wayneblaylock/landing-assist/README.md

# landing-assist

Pilot-facing landing-assist advisory for experimental-aircraft flight test.

- `hardware/` — schematic, bill of materials
- `display/` — pilot horizon GUI (artificial horizon, pitch cues, height tape)
- `firmware/` — ESP-IDF project for firmware
