wayneblaylock/landing-assist/case/README.md

Case design done in FreeCAD v1.1.4

Originaly started in Fusion360 but the cloud ecosystem is a nightmare, and was NOT lightweight.

'./sources/' - Files downloaded from the internet, or generated from other cad programs like KiCad.
'./assembly.FCstd' - The full assembly.
'./case.FCstd' - The 3D printed case.
