wayneblaylock/landing-assist/display/README.md

# Display

Static pilot horizon (ADI) page for the landing-assist system.

This is a single self-contained HTML file (`index.html`). It is the page the ESP32 serves over its SoftAP so the cockpit phone can open it.

To preview locally, open `index.html` in a browser. The Dev panel lets you move the cues until the ESP32 is feeding live data.
