wayneblaylock/landing-assist/hardware/KiCad/README.md

ECE Capstone KiCad schematic and PCB design files
