wayneblaylock/landing-assist/hardware/BOM/ECE Captstone BOM.xlsx

Sheet: BOM Final
Category | Manufacturer | Part Number | Description | QTY | Unit Price | Price Each | Notes | Source
SMD | Espressif Systems | ESP32-S3-WROOM-1U-N16R8 | Bluetooth, WiFi 802.11b/g/n, Bluetooth v5.0 Transceiver Module 2.4GHz Antenna Not Included, U.FL Surface Mount | 1 | $6.76 | $6.76 |  | https://www.digikey.com/en/products/detail/espressif-systems/ESP32-S3-WROOM-1U-N8R8/16162638
SMD | Bosch Sensortec | BMI088 | ACCELEROMETER 16LGA | 0 | $5.92 | $0.00 | OUT OF STOCK, | https://www.digikey.com/en/products/detail/bosch-sensortec/BMI088/8634936
SMD | Texas Instruments | TPS22919DCKR | Load Sw | 10 | $0.17 | $1.70 | Cut tape | https://www.digikey.com/en/products/detail/texas-instruments/TPS22919DCKR/10434801
Connector | Amphenol ICC (FCI) | 10176546-00011LF | USB-C (USB TYPE-C) Receptacle Connector 24 (16+8 Dummy) Position Through Hole, Right Angle | 3 | $1.13 | $3.39 |  | https://www.digikey.com/en/products/detail/amphenol-cs-fci/10176546-00011LF/26473252
Connector | JST | SM08B-SURS-TF | JST SUR 8 position right angle connector SMT | 3 | $1.04 | $3.12 | For Lidar May also use vertical version if desired(BM08B-SURS-TF) | https://www.digikey.com/en/products/detail/jst-sales-america-inc/SM08B-SURS-TF/1634781
SMD | Microchip Technology | MCP73831T-2ACI/OT | Lion CCCV Charger | 3 | $0.76 | $2.28 |  | https://www.digikey.com/en/products/detail/microchip-technology/MCP73831T-2ACI-OT/964301
SMD | Texas Instruments | LM27313XMF/NOPB | IC REG BOOST ADJ 800MA SOT23-5 | 3 | $2.52 | $7.56 |  | https://www.digikey.com/en/products/detail/texas-instruments/LM27313XMF-NOPB/1590046
SMD | Texas Instruments | TPS62162DSGR | IC REG BUCK 3.3V 1A 8WSON | 3 | $1.99 | $5.97 |  | https://www.digikey.com/en/products/detail/texas-instruments/TPS62162DSGR/2833447
Connector | JST | S2B-PH-K-S | JST-PH 2 pos | 3 | $0.12 | $0.36 | for battery connection | https://www.digikey.com/en/products/detail/jst-sales-america-inc/S2B-PH-K-S/926626
Passives | onsemi | MBR0520LT3G | DIODE SCHOTTKY 20V 500MA SOD123 | 3 | $0.37 | $1.11 |  | https://www.digikey.com/en/products/detail/onsemi/MBR0520LT3G/1477142
Passives | Murata Electronics | GRM033R61A104ME15D | CAP CER 0.1UF 10V X5R 0201 | 50 | $0.01 | $0.47 |  | https://www.digikey.com/en/products/detail/murata-electronics/GRM033R61A104ME15D/2175191
Passives | Murata Electronics | GRT188R61C106KE13D | CAP CER 10UF 16V X5R 0603 | 10 | $0.17 | $1.75 |  | https://www.digikey.com/en/products/detail/murata-electronics/GRT188R61C106KE13D/5416739
Passives | Murata Electronics | GCM188R71E105KA64D | CAP CER 1UF 25V X7R 0603 | 10 | $0.11 | $1.09 |  | https://www.digikey.com/en/products/detail/murata-electronics/GCM188R71E105KA64D/4903956
Passives | Murata Electronics | GRM188R61E475KE11D | 4.7 µF ±10% 25V Ceramic Capacitor X5R 0603 (1608 Metric) | 10 | $0.14 | $1.41 |  | https://www.digikey.com/en/products/detail/murata-electronics/GRM188R61E475KE11D/3900465
Passives |  |  | LED, THT, 5mm | 0 |  | $0.00 | do not purchase
Passives | TDK | VLS6045EX-100M | FIXED IND 10UH 3.4A 47 MOHM SMD | 3 | $0.35 | $1.05 | cut tape | https://www.digikey.com/en/products/detail/tdk/VLS6045EX-100M/5057822
Passives | TDK | VLS252012ET-2R2M | FIXED IND 2.2UH 1.3A 154 MOHM | 3 | $0.28 | $0.84 | cut tape | https://www.digikey.com/en/products/detail/tdk/VLS252012ET-2R2M/2465978
Passives | YAGEO | RC0402FR-0710KL | 10 kOhms ±1% 0.063W, 1/16W Chip Resistor 0402 (1005 Metric) Moisture Resistant Thick Film | 25 | $0.02 | $0.38 |  | https://www.digikey.com/en/products/detail/yageo/RC0402FR-0710KL/726523
Passives | YAGEO | RC0402FR-071KL | 1 kOhms ±1% 0.063W, 1/16W Chip Resistor 0402 (1005 Metric) Moisture Resistant Thick Film | 25 | $0.02 | $0.38 |  | https://www.digikey.com/en/products/detail/yageo/RC0402FR-071KL/726513
Passives | YAGEO | RC0402JR-074K7L | RES 4.7K OHM 5% 1/16W 0402 | 25 | $0.01 | $0.36 |  | https://www.digikey.com/en/products/detail/yageo/RC0402JR-074K7L/726477
Passives | YAGEO | RC0402FR-075K1L | 5.1 kOhms ±1% 0.063W, 1/16W Chip Resistor 0402 (1005 Metric) Moisture Resistant Thick Film | 25 | $0.02 | $0.38 |  | https://www.digikey.com/en/products/detail/yageo/RC0402FR-075K1L/726624
Passives | YAGEO | AC0402FR-07309KL | 309 kOhms ±1% 0.063W, 1/16W Chip Resistor 0402 (1005 Metric) Automotive AEC-Q200, Moisture Resistant Thick Film | 10 | $0.02 | $0.24 |  | https://www.digikey.com/en/products/detail/yageo/AC0402FR-07309KL/5895272
Passives | YAGEO | RC0402FR-07100KL | RES 100K OHM 1% 1/16W 0402 | 10 | $0.02 | $0.21 |  | https://www.digikey.com/en/products/detail/yageo/RC0402FR-07100KL/726526
SMD | C&K | PTS645SH43SMTR92 LFS | SWITCH TACTILE SPST-NO 0.05A 12V | 5 | $0.39 | $1.95 |  | https://www.digikey.com/en/products/detail/c-k/PTS645SH43SMTR92-LFS/1145472
Breakout | Espressif Systems | ESP32-S3-DEVKITC-1U-N8R8 | ESP32-S3 development board using ESP32-S3-WROOM-1U-N8R8; Wi-Fi + BLE | 2 | $15.31 | $30.62 | the module on it is ESP32-S3-WROOM-1U-N8R8. | https://www.mouser.com/en/ProductDetail/Espressif-Systems/ESP32-S3-DevKitC-1U-N8R8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
Final | TE Connectivity Measurement Specialties | 4525DO-DS5AI001DP | 1 psi differential pressure sensor, 14-bit, dual 0.14 in barbed ports | 1 | $72.41 | $72.41 | This will be the final soldered part, but we can test using small clamps/leads to the through-hole pins .5 V supply; differential pressure; intended for pitot/static airspeed measurement. | https://www.digikey.com/en/products/detail/te-connectivity-measurement-specialties/4525DO-DS5AI001DP/3569051
Breakout | Bosch Sensortec | 828-SHUTTLEBOARD3.0BMI088-ND | Breakout: 6-axis accelerometer + gyroscope IMU, I2C/SPI, 16-LGA | 2 | $16.20 | $32.40 | Breakout version of the part to be used (BMI088) | https://www.digikey.com/en/products/detail/bosch-sensortec/SHUTTLE-BOARD-3-0-BMI088/14617528
Final | LightWare LiDAR Inc. | SF20/C | 100 m-class optical distance sensor, I2C / serial, 4.5-5.5 V | 1 | $319.00 | $319.00 | Please order at mouser, out of stock at digikey. | https://www.digikey.com/en/products/detail/lightware-lidar-inc/SF20-C/15848650
Harness (Final) | JST | A08SUR08SUR32W102B | JST SUR 8 pos cable 4” | 2 | $2.13 | $4.26 | I think 1:N is correct based on the provided datasheet | https://www.digikey.com/en/products/detail/jst-sales-america-inc/A08SUR08SUR32W102B/9947457
Breakout | LightWare LiDAR Inc. | ACC_BOB_08SUR-32S | lightware breakout board | 0 |  | $0.00 | do not purchase
Antenna (Final) | Pulse Electronics | W1049B050 | RF ANTENNA Bluetooth, Wi-Fi, WLAN, Zigbee™ Whip, Tilt U.FL (UMCC), I-PEX MHF1 Connector Mount | 1 | $4.49 | $4.49 | U.FL direct | https://www.digikey.com/en/products/detail/pulse-electronics/W1049B050/2267887
Coax Adapter | Adafruit | 852 | RP-SMA to uFL/u.FL/IPX/IPEX RF Adapter Cable | 0 |  | $0.00 | do not purchase | https://www.digikey.com/en/products/detail/adafruit-industries-llc/852/6827042
Pneumatic Tubing |  |  | Tubing 5ft | 0 |  | $0.00 | do not purchase | https://www.mcmaster.com/2121T15-2121T151/
Battery (Final) | Adafruit | 1781 | 18650 3.7 V Lithium-Ion Battery Rechargeable (Secondary) 2.2Ah | 2 | $9.95 | $19.90 |  | https://www.digikey.com/en/products/detail/adafruit-industries-llc/1781/5054543
Testing | DFRobot | KIT0198-US | GNSS-RTK High Precision Positioning Kit with LoRa (US 915 MHz, GPS / GLONASS / Galileo / BDS / QZSS) | 1 | $169.00 | $169.00 | for calibrating sensors | https://www.digikey.com/en/products/detail/dfrobot/KIT0198-US/28531129
PCB |  | PCB Estimate | PCB with Stencil estimate from JLCPCB and PCBWay | 1 | $90.00 | $90.00 | Estimate only; not for immediate purchase, unit cost is actually qty 5 pcbs totalling $90
Solder Paste | Chip Quik Inc. | NC191LT10 |  | 1 | $17.99 | $17.99 |  | https://www.digikey.com/en/products/detail/chip-quik-inc/SMD291AXT4/8543521
 |  |  |  | Total |  | $802.83

Sheet: BOM PCB
Category | Manufacturer | Part Number | Description | QTY | Price | Notes | Source | Source2
SMD | Espressif Systems | ESP32-S3-WROOM-1U-N16R8 | Bluetooth, WiFi 802.11b/g/n, Bluetooth v5.0 Transceiver Module 2.4GHz Antenna Not Included, U.FL Surface Mount | 1 | 6.76 |  | https://www.digikey.com/en/products/detail/espressif-systems/ESP32-S3-WROOM-1U-N8R8/16162638
SMD | Bosch Sensortec | BMI088 | ACCELEROMETER 16LGA | 0 | 5.92 | OUT OF STOCK, | https://www.digikey.com/en/products/detail/bosch-sensortec/BMI088/8634936 | https://www.mouser.com/en/ProductDetail/Bosch-Sensortec/BMI088?qs=f9yNj16SXrIMFspTV6RB6Q%3D%3D
SMD | Texas Instruments | TPS22919DCKR | Load Sw | 10 | 1.7 | Cut tape | https://www.digikey.com/en/products/detail/texas-instruments/TPS22919DCKR/10434801
Connector | Amphenol ICC (FCI) | 10176546-00011LF | USB-C (USB TYPE-C) Receptacle Connector 24 (16+8 Dummy) Position Through Hole, Right Angle | 3 | 3.39 |  | https://www.digikey.com/en/products/detail/amphenol-cs-fci/10176546-00011LF/26473252
Connector | JST | SM08B-SURS-TF | JST SUR 8 position right angle connector SMT | 3 | 3.12 | For Lidar May also use vertical version if desired(BM08B-SURS-TF) | https://www.digikey.com/en/products/detail/jst-sales-america-inc/SM08B-SURS-TF/1634781
SMD | Microchip Technology | MCP73831T-2ACI/OT | Lion CCCV Charger | 3 | 2.28 |  | https://www.digikey.com/en/products/detail/microchip-technology/MCP73831T-2ACI-OT/964301
SMD | Texas Instruments | LM27313XMF/NOPB | IC REG BOOST ADJ 800MA SOT23-5 | 3 | 7.56 |  | https://www.digikey.com/en/products/detail/texas-instruments/LM27313XMF-NOPB/1590046
SMD | Texas Instruments | TPS62162DSGR | IC REG BUCK 3.3V 1A 8WSON | 3 | 5.97 |  | https://www.digikey.com/en/products/detail/texas-instruments/TPS62162DSGR/2833447
Connector | JST | S2B-PH-K-S | JST-PH 2 pos | 3 | 0.36 | for battery connection | https://www.digikey.com/en/products/detail/jst-sales-america-inc/S2B-PH-K-S/926626
Passives | onsemi | MBR0520LT3G | DIODE SCHOTTKY 20V 500MA SOD123 | 3 | 1.11 |  | https://www.digikey.com/en/products/detail/onsemi/MBR0520LT3G/1477142
Passives | Murata Electronics | GRM033R61A104ME15D | CAP CER 0.1UF 10V X5R 0201 | 50 | 0.44 |  | https://www.digikey.com/en/products/detail/murata-electronics/GRM033R61A104ME15D/2175191
Passives | Murata Electronics | GRT188R61C106KE13D | CAP CER 10UF 16V X5R 0603 | 10 | 1.75 |  | https://www.digikey.com/en/products/detail/murata-electronics/GRT188R61C106KE13D/5416739
Passives | Murata Electronics | GCM188R71E105KA64D | CAP CER 1UF 25V X7R 0603 | 10 | 1.09 |  | https://www.digikey.com/en/products/detail/murata-electronics/GCM188R71E105KA64D/4903956
Passives | Murata Electronics | GRM188R61E475KE11D | 4.7 µF ±10% 25V Ceramic Capacitor X5R 0603 (1608 Metric) | 10 | 1.41 |  | https://www.digikey.com/en/products/detail/murata-electronics/GRM188R61E475KE11D/3900465
Passives |  |  | LED, THT, 5mm | 0 |  | do not purchase
Passives | TDK | VLS6045EX-100M | FIXED IND 10UH 3.4A 47 MOHM SMD | 3 | 1.05 | cut tape | https://www.digikey.com/en/products/detail/tdk/VLS6045EX-100M/5057822
Passives | TDK | VLS252012ET-2R2M | FIXED IND 2.2UH 1.3A 154 MOHM | 3 | 0.84 | cut tape | https://www.digikey.com/en/products/detail/tdk/VLS252012ET-2R2M/2465978
Passives | YAGEO | RC0402FR-0710KL | 10 kOhms ±1% 0.063W, 1/16W Chip Resistor 0402 (1005 Metric) Moisture Resistant Thick Film | 25 | 0.38 |  | https://www.digikey.com/en/products/detail/yageo/RC0402FR-0710KL/726523
Passives | YAGEO | RC0402FR-071KL | 1 kOhms ±1% 0.063W, 1/16W Chip Resistor 0402 (1005 Metric) Moisture Resistant Thick Film | 25 | 0.38 |  | https://www.digikey.com/en/products/detail/yageo/RC0402FR-071KL/726513
Passives | YAGEO | RC0402JR-074K7L | RES 4.7K OHM 5% 1/16W 0402 | 25 | 0.36 |  | https://www.digikey.com/en/products/detail/yageo/RC0402JR-074K7L/726477
Passives | YAGEO | RC0402FR-075K1L | 5.1 kOhms ±1% 0.063W, 1/16W Chip Resistor 0402 (1005 Metric) Moisture Resistant Thick Film | 25 | 0.38 |  | https://www.digikey.com/en/products/detail/yageo/RC0402FR-075K1L/726624
Passives | YAGEO | AC0402FR-07309KL | 309 kOhms ±1% 0.063W, 1/16W Chip Resistor 0402 (1005 Metric) Automotive AEC-Q200, Moisture Resistant Thick Film | 10 | 0.24 |  | https://www.digikey.com/en/products/detail/yageo/AC0402FR-07309KL/5895272
Passives | YAGEO | RC0402FR-07100KL | RES 100K OHM 1% 1/16W 0402 | 10 | 0.21 |  | https://www.digikey.com/en/products/detail/yageo/RC0402FR-07100KL/726526
SMD | C&K | PTS645SH43SMTR92 LFS | SWITCH TACTILE SPST-NO 0.05A 12V | 5 | 1.95 |  | https://www.digikey.com/en/products/detail/c-k/PTS645SH43SMTR92-LFS/1145472

Sheet: BOM Breadboard
Category | Manufacturer | Part Number | Description | QTY | Price | Notes | Source | Source2
Breakout | Espressif Systems | ESP32-S3-DEVKITC-1U-N8R8 | ESP32-S3 development board using ESP32-S3-WROOM-1U-N8R8; Wi-Fi + BLE | 2 | $15 | Linked DigiKey board is the DevKitC; the module on it is ESP32-S3-WROOM-1U-N8R8. | https://www.digikey.com/en/products/detail/espressif-systems/ESP32-S3-DEVKITC-1U-N8R8/16162636 | https://www.mouser.com/en/ProductDetail/Espressif-Systems/ESP32-S3-DevKitC-1U-N8R8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
Final | TE Connectivity Measurement Specialties | 4525DO-DS5AI001DP | 1 psi differential pressure sensor, 14-bit, dual 0.14 in barbed ports | 1 | $72.41 | This will be the final soldered part, but we can test using small clamps/leads to the through-hole pins .5 V supply; differential pressure; intended for pitot/static airspeed measurement. | https://www.digikey.com/en/products/detail/te-connectivity-measurement-specialties/4525DO-DS5AI001DP/3569051 | https://www.mouser.com/en/ProductDetail/TE-Connectivity-Measurement-Specialties/4525DO-DS5AI001DP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
Breakout | Bosch Sensortec | 828-SHUTTLEBOARD3.0BMI088-ND | Breakout: 6-axis accelerometer + gyroscope IMU, I2C/SPI, 16-LGA | 2 | $32.40 | Breakout version of the part to be used (BMI088) | https://www.digikey.com/en/products/detail/bosch-sensortec/SHUTTLE-BOARD-3-0-BMI088/14617528
Final | LightWare LiDAR Inc. | SF20/C | 100 m-class optical distance sensor, I2C / serial, 4.5-5.5 V | 1 | $319.00 | Consider SF20/C instead, in stock at mouser | https://www.mouser.com/en/ProductDetail/LightWare-LiDAR/SF20-C?qs=iLbezkQI%252Bsj8XPNk6jtsvg%3D%3D
Harness (Final) | JST | A08SUR08SUR32W102B | JST SUR 8 pos cable 4” | 2 | 4.26 | I think 1:N is correct based on the provided datasheet | https://www.digikey.com/en/products/detail/jst-sales-america-inc/A08SUR08SUR32W102B/9947457
Breakout | LightWare LiDAR Inc. | ACC_BOB_08SUR-32S | lightware breakout board | 0 |  | do not purchase
Antenna (Final) | Pulse Electronics | W1049B050 | RF ANTENNA Bluetooth, Wi-Fi, WLAN, Zigbee™ Whip, Tilt U.FL (UMCC), I-PEX MHF1 Connector Mount | 1 | 4.49 | U.FL direct | https://www.digikey.com/en/products/detail/pulse-electronics/W1049B050/2267887
Coax Adapter | Adafruit | 852 | RP-SMA to uFL/u.FL/IPX/IPEX RF Adapter Cable | 0 |  | do not purchase | https://www.digikey.com/en/products/detail/adafruit-industries-llc/852/6827042
Pneumatic Tubing |  |  |  | 0 |  | do not purchase
Battery (Final) | Adafruit | 1781 | 18650 3.7 V Lithium-Ion Battery Rechargeable (Secondary) 2.2Ah | 2 | 19.9 |  | https://www.digikey.com/en/products/detail/adafruit-industries-llc/1781/5054543

Sheet: Sheet1
Category | Manufacturer | Part Number | Description | QTY | Price | Notes | Source
MCU | Espressif Systems | ESP32-S3-DEVKITC-1U-N8R8 | ESP32-S3 development board using ESP32-S3-WROOM-1U-N8R8; Wi-Fi + BLE | 1 | $15 | Linked DigiKey board is the DevKitC; the module on it is ESP32-S3-WROOM-1U-N8R8. | https://www.digikey.com/en/products/detail/espressif-systems/ESP32-S3-DEVKITC-1U-N8R8/16162636
Airspeed | TE Connectivity Measurement Specialties | 4525DO-DS5AI001DP | 1 psi differential pressure sensor, 14-bit, dual 0.14 in barbed ports | 1 | $72.41 | 5 V supply; differential pressure; intended for pitot/static airspeed measurement. | https://www.digikey.com/en/products/detail/te-connectivity-measurement-specialties/4525DO-DS5AI001DP/3569051
IMU | Bosch Sensortec | BMI088 | 6-axis accelerometer + gyroscope IMU, I2C/SPI, 16-LGA | 1 | $5.92 | Surface-mount part for final PCB; -40 C to +85 C operating range. | https://www.digikey.com/en/products/detail/bosch-sensortec/BMI088/8634936
LiDAR | LightWare LiDAR Inc. | LW20/C | 100 m-class optical distance sensor, I2C / serial, 4.5-5.5 V | 1 | $299.30 | 20 cm to 100 m sensing range; about 100 mA supply per DigiKey. | https://www.digikey.com/en/products/detail/lightware-lidar-inc/LW20-C/15848653
Battery Option A | Adafruit | Product ID 1781 | 3.7 V 2200 mAh protected lithium-ion cylindrical battery with JST-PH | 1 | $9.95 | Lower-cost/lower-capacity battery option. | https://www.adafruit.com/product/1781
Battery Option B | Adafruit | Product ID 354 | 3.7 V 4400 mAh protected lithium-ion battery pack with JST connector | 1 | $19.95 | Higher-capacity option; larger/heavier than 2200 mAh pack. | https://www.adafruit.com/product/354
Battery Charger Option A | Microchip Technology | MCP73831T-2ACI/OT | Single-cell Li-Ion/Li-Poly charger IC, programmable charge current | 1 | $0.76 | 4.2 V single-cell charger; up to 500 mA charge current for this part. | https://www.digikey.com/en/products/detail/microchip-technology/MCP73831T-2ACI-OT/964301
Battery Charger Option B | Texas Instruments | BQ21040DBVR | Single-cell Li-Ion/Li-Poly charger IC, programmable charging | 1 | $0.99 | 4.2 V single-cell charger; 6.45 V max supply. | https://www.digikey.com/en/products/detail/texas-instruments/BQ21040DBVR/6036340
5 V Boost Regulator | Texas Instruments | LM27313XMF/NOPB | Adjustable boost regulator, 5 V minimum output setting, 800 mA switch | 1 | $2.42 | 2.7-14 V input; use external inductor/diode/capacitors per datasheet. | https://www.digikey.com/en/products/detail/texas-instruments/LM27313XMF-NOPB/1590046
3.3 V Regulator Option A | Semtech Corporation | SC189ZSKTRT | 3.3 V fixed buck regulator, 1.5 A | 1 | $1.07 | 2.9-5.5 V input. Check dropout/operation near a discharged 1-cell Li-ion battery. | https://www.digikey.com/en/products/detail/semtech-corporation/SC189ZSKTRT/2182360
3.3 V Regulator Option B | Texas Instruments | TPS62162DSGR | 3.3 V fixed buck regulator, 1 A | 1 | $1.86 | 3-17 V input. Check operation as battery approaches 3.3 V. | https://www.digikey.com/en/products/detail/texas-instruments/TPS62162DSGR/2833447
Total (including alternative) | $429.63
Core total (ESP32 + airspeed + IMU + LiDAR + LiDAR connector + 2200mAh battery + MCP73831 + LM27313) |  |  | $405.76
