wayneblaylock/landing-assist/case/assembly.FCStd

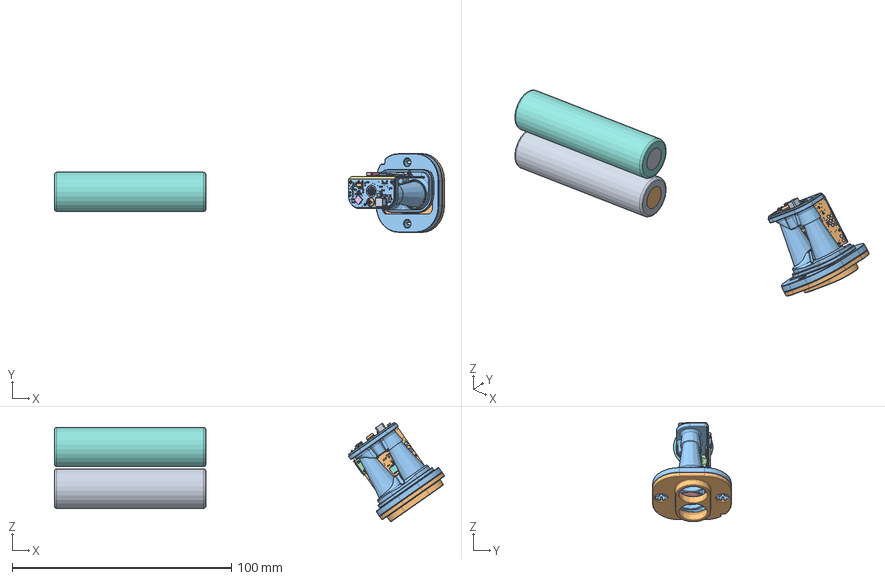
[picture p1: CAD file, 2026-10-19]
case/assembly.FCStd
177.8 x 36.0 x 45.3 mm
2200mAh Battery v1
2200mAh Battery v001
(Unsaved)
(Unsaved)001
(Unsaved)002
(Unsaved)003
(Unsaved)004
(Unsaved)005
(Unsaved)006
(Unsaved)007
(Unsaved)008
(Unsaved)009
(Unsaved)010
(Unsaved)011
(Unsaved)012
(Unsaved)013
(Unsaved)014
(Unsaved)015
(Unsaved)016
(Unsaved)017
(Unsaved)018
(Unsaved)019
(Unsaved)020
(Unsaved)021
(Unsaved)022
(Unsaved)023
(Unsaved)024
(Unsaved)025
(Unsaved)026
(Unsaved)027
(Unsaved)028
(Unsaved)029
(Unsaved)030
(Unsaved)031
(Unsaved)032
(Unsaved)033
(Unsaved)034
(Unsaved)035
(Unsaved)036
(Unsaved)037
(Unsaved)038
(Unsaved)039
(Unsaved)040
(Unsaved)041
(Unsaved)042
(Unsaved)043
(Unsaved)044
(Unsaved)045
(Unsaved)046
(Unsaved)047
(Unsaved)048
(Unsaved)049
(Unsaved)050
(Unsaved)051
(Unsaved)052
(Unsaved)053
(Unsaved)054
(Unsaved)055
(Unsaved)056
(Unsaved)057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
