wayneblaylock/landing-assist/case/sources/LightWare SF20 Mounting Bracket.step

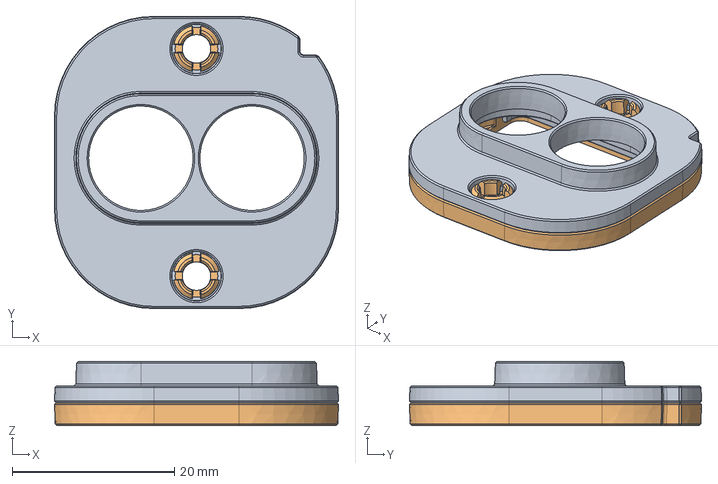
[picture p2: CAD file, 2026-10-19]
case/sources/LightWare SF20 Mounting Bracket.step
35.0 x 36.0 x 7.90 mm
