wayneblaylock/landing-assist/hardware/KiCad/3D_models/10176546c.stp

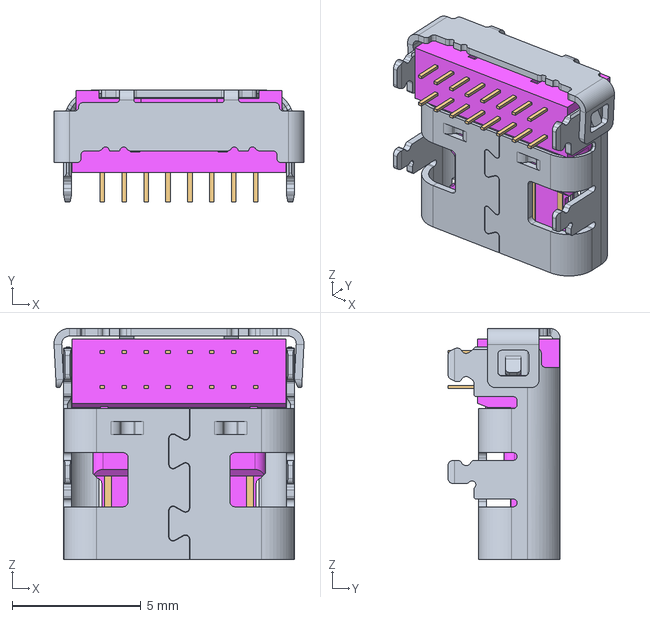
[picture p3: CAD file, 2026-11-03]
hardware/KiCad/3D_models/10176546c.stp
9.70 x 4.36 x 8.97 mm
