wayneblaylock/landing-assist/(list of files, cad)

Other CAD files:
case/sources/LightWare SF20 CAD.step
