wayneblaylock/landing-assist/hardware/KiCad/ECE Capstone Schematic.kicad_pcb

## KiCad design hardware/KiCad/ECE Capstone Schematic.kicad_pcb (2026-11-03)

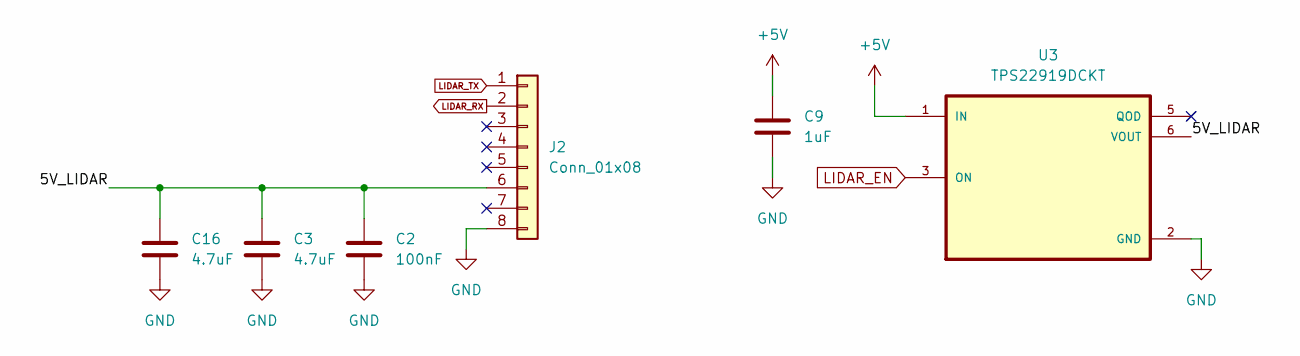
[picture p4: schematic lidar.kicad_sch]

Parts:
C2: 100nF; C_0201_0603Metric_Pad0.64x0.40mm_HandSolder
C3, C16: 4.7uF; C_0603_1608Metric_Pad1.08x0.95mm_HandSolder
C9: 1uF; C_0603_1608Metric_Pad1.08x0.95mm_HandSolder
J2: Conn_01x08; JST_SUR_SM08B-SURS-TF_1x08-1MP_P0.80mm_Horizontal
U3: TPS22919DCKT; SOT-363_SC-70-6; DigiKey_Part_Number 296-53421-1-ND

Connections:
+5V: C9.1, U3.1 (IN); also elsewhere on the board
/LiDAR/5V_LIDAR: C2.1, C3.1, C16.1, J2.6, U3.6 (VOUT)
GND: C2.2, C3.2, C9.2, C16.2, J2.8, U3.2 (GND); also elsewhere on the board
LIDAR_EN: U3.3 (ON); also elsewhere on the board
LIDAR_RX: J2.2; also elsewhere on the board
LIDAR_TX: J2.1; also elsewhere on the board

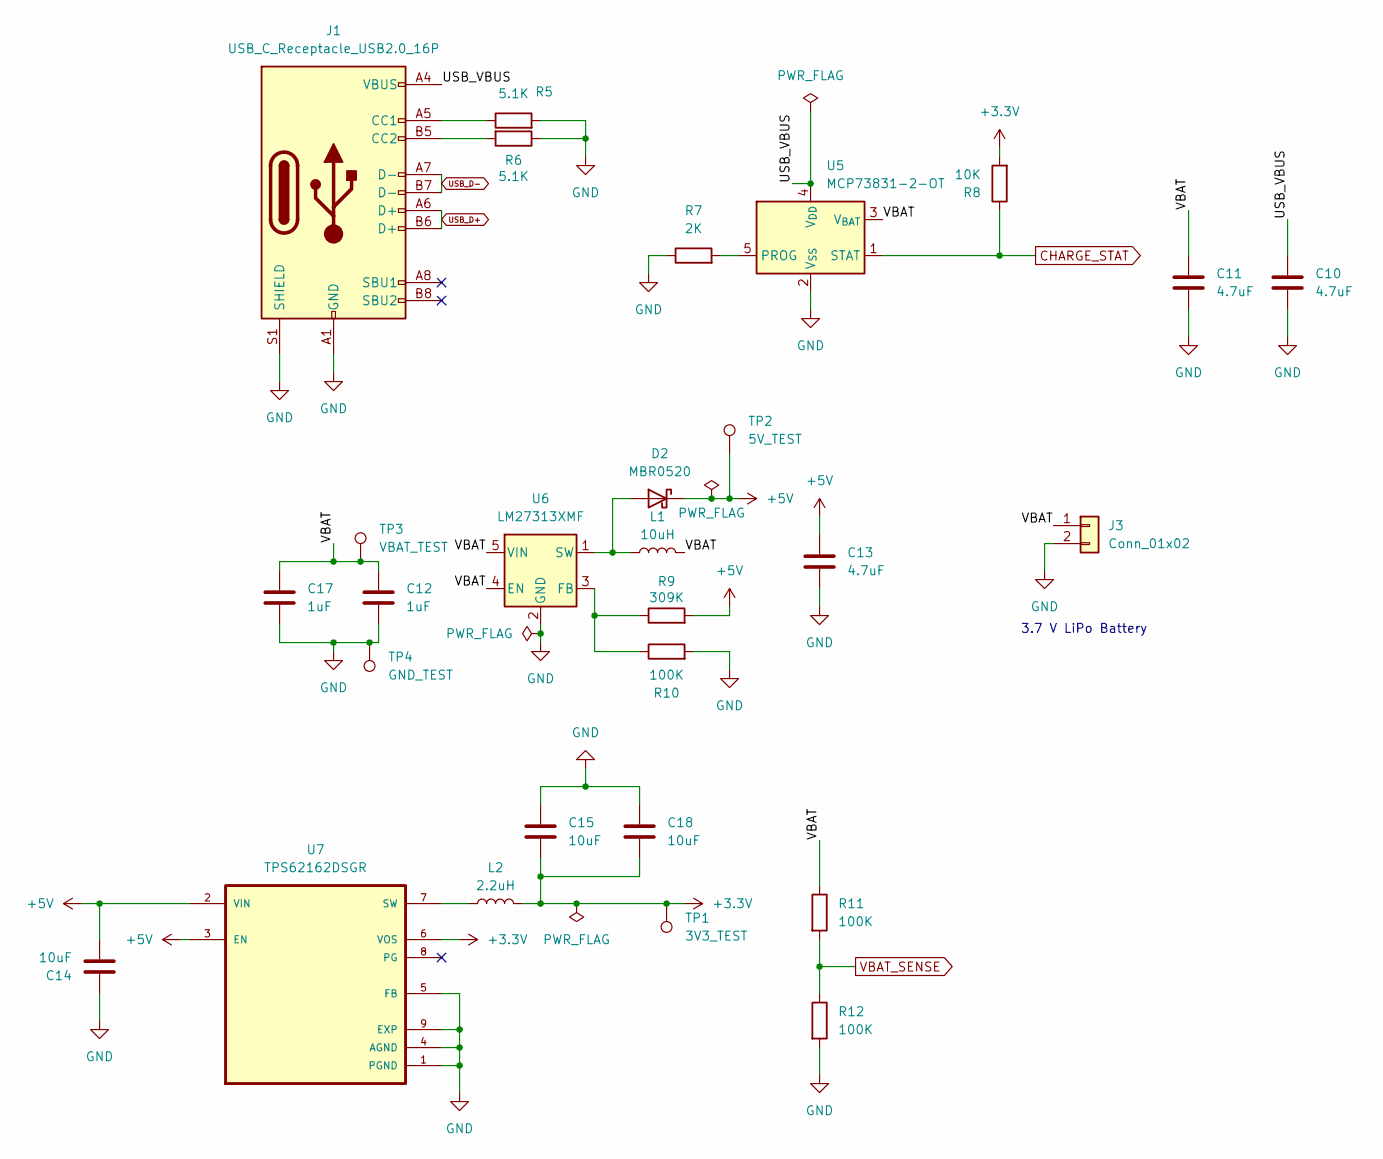
[picture p5: schematic power.kicad_sch]

Parts:
C10, C11, C13: 4.7uF; C_0603_1608Metric_Pad1.08x0.95mm_HandSolder
C12, C17: 1uF; C_0603_1608Metric_Pad1.08x0.95mm_HandSolder
C14: 10uF; C_0603_1608Metric_Pad1.08x0.95mm_HandSolder
C15, C18: 10uF; C_0805_2012Metric_Pad1.18x1.45mm_HandSolder
D2: MBR0520; D_SOD-123
J1: USB_C_Receptacle_USB2.0_16P; 10176546-00011LF_KiCad9
J3: Conn_01x02; JST_PH_S2B-PH-K_1x02_P2.00mm_Horizontal
L1: 10uH; L_TDK_VLS6045EX_VLS6045AF
L2: 2.2uH; IND_VLS252012ET-2R2M
R5, R6: 5.1K; R_0603_1608Metric_Pad0.98x0.95mm_HandSolder
R7: 2K; R_0603_1608Metric_Pad0.98x0.95mm_HandSolder
R8: 10K; R_0603_1608Metric_Pad0.98x0.95mm_HandSolder
R9: 309K; R_0603_1608Metric_Pad0.98x0.95mm_HandSolder
R10, R11, R12: 100K; R_0603_1608Metric_Pad0.98x0.95mm_HandSolder
TP1: 3V3_TEST; TestPoint_Pad_D1.5mm
TP2: 5V_TEST; TestPoint_Pad_D1.5mm
TP3: VBAT_TEST; TestPoint_Pad_D1.5mm
TP4: GND_TEST; TestPoint_Pad_D1.5mm
U5: MCP73831-2-OT; SOT-23-5
U6: LM27313XMF; SOT-23-5
U7: TPS62162DSGR; Texas_DSG0008A_WSON-8-1EP_2x2mm_P0.5mm_EP0.9x1.6mm; PARTREV E; DigiKey_Part_Number 296-43671-1-ND

Connections:
+3.3V: C15.2, C18.2, L2.2, R8.2, TP1.1, U7.6 (VOS); also elsewhere on the board
+5V: C13.1, C14.2, D2.1 (K), R9.2, TP2.1, U7.2 (VIN), U7.3 (EN); also elsewhere on the board
/POWER/USB_VBUS: C10.1, J1.A4 (VBUS), J1.A9 (VBUS), J1.B4 (VBUS), J1.B9 (VBUS), U5.4 (V_{DD})
/POWER/VBAT: C11.1, C12.1, C17.1, J3.1, L1.2, R11.1, TP3.1, U5.3 (V_{BAT}), U6.4 (EN), U6.5 (VIN)
CHARGE_STAT: R8.1, U5.1 (STAT); also elsewhere on the board
GND: C10.2, C11.2, C12.2, C13.2, C14.1, C15.1, C17.2, C18.1, J1.A1 (GND), J1.A12 (GND), J1.B1 (GND), J1.B12 (GND), J1.S1 (SHIELD), J3.2, R5.2, R6.1, R7.1, R10.2, R12.2, TP4.1, U5.2 (V_{SS}), U6.2 (GND), U7.1 (PGND), U7.4 (AGND), U7.5 (FB), U7.9 (EXP); also elsewhere on the board
unnamed: D2.2 (A), L1.1, U6.1 (SW)
unnamed: J1.A5 (CC1), R5.1
unnamed: J1.B5 (CC2), R6.2
unnamed: R7.2, U5.5 (PROG)
unnamed: R9.1, R10.1, U6.3 (FB)
unnamed: L2.1, U7.7 (SW)
USB_D+: J1.A6 (D+), J1.B6 (D+); also elsewhere on the board
USB_D-: J1.A7 (D-), J1.B7 (D-); also elsewhere on the board
VBAT_SENSE: R11.2, R12.1; also elsewhere on the board

Notes on the sheet:
3.7 V LiPo Battery

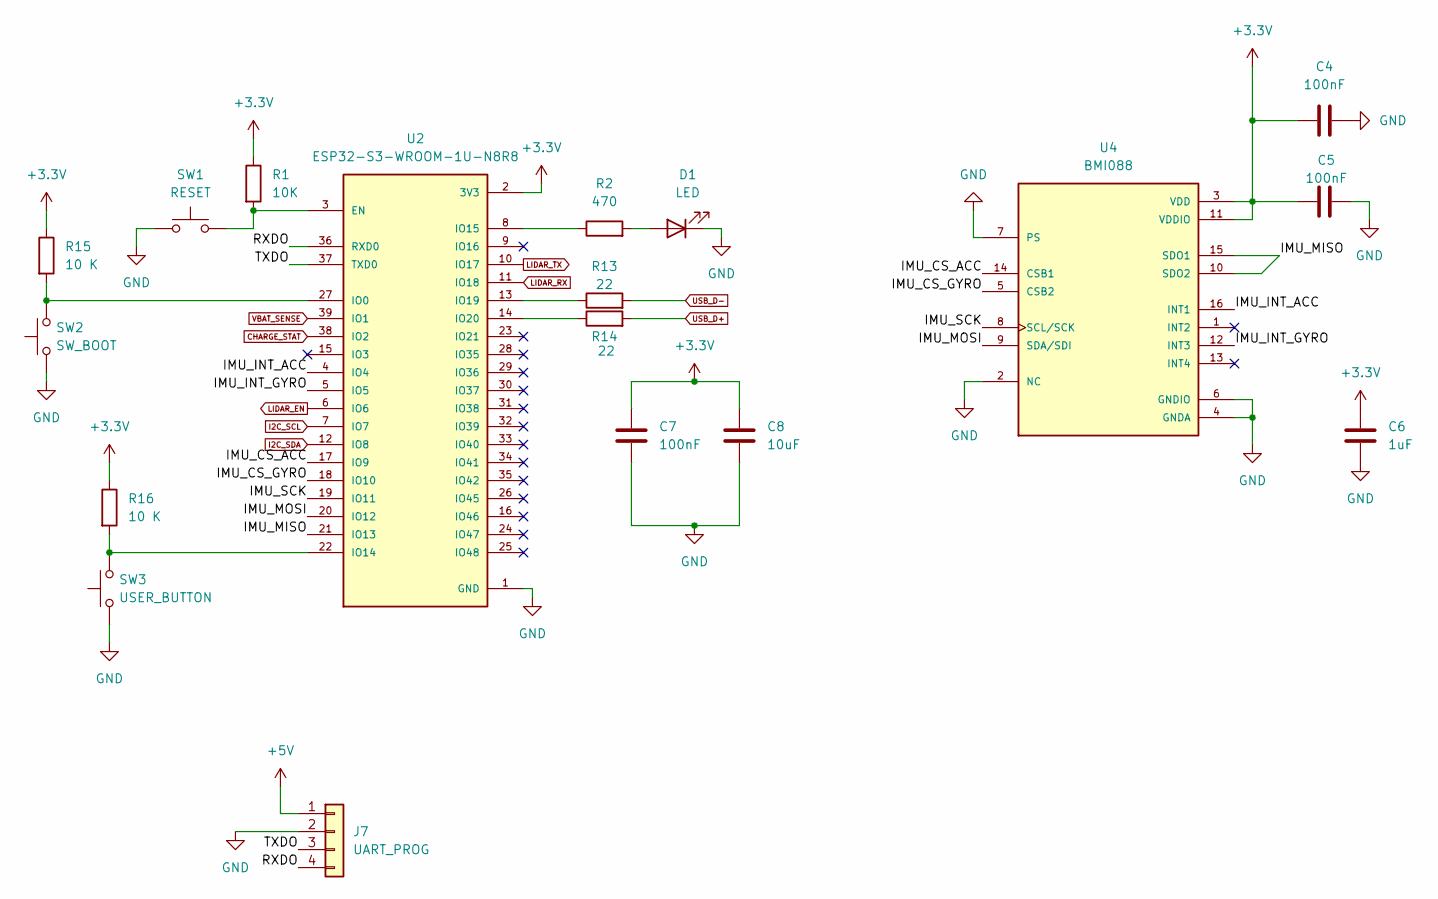
[picture p6: schematic mcu_imu.kicad_sch]

Parts:
C4, C5, C7: 100nF; C_0201_0603Metric_Pad0.64x0.40mm_HandSolder
C6: 1uF; C_0603_1608Metric_Pad1.08x0.95mm_HandSolder
C8: 10uF; C_0603_1608Metric_Pad1.08x0.95mm_HandSolder
D1: LED; LED_0603_1608Metric_Pad1.05x0.95mm_HandSolder
J7: UART_PROG; PinHeader_1x04_P2.54mm_Vertical
R1: 10K; R_0603_1608Metric_Pad0.98x0.95mm_HandSolder
R2: 470; R_0603_1608Metric_Pad0.98x0.95mm_HandSolder
R13, R14: 22; R_0402_1005Metric_Pad0.72x0.64mm_HandSolder
R15, R16: 10 K; R_0603_1608Metric_Pad0.98x0.95mm_HandSolder
SW1: RESET; SW_PUSH_6mm
SW2: SW_BOOT; SW_PUSH_6mm
SW3: USER_BUTTON; SW_PUSH_6mm
U2: ESP32-S3-WROOM-1U-N8R8; ESP32-S3-WROOM-1U; PARTREV v1.1; DigiKey_Part_Number 1965-ESP32-S3-WROOM-1U-N8R8CT-ND
U4: BMI088; Bosch_LGA-16_4.5x3mm_P0.5mm_LayoutBorder7x1y_ClockwisePinNu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; DigiKey_Part_Number 828-1082-1-ND

Connections:
+3.3V: C4.1, C5.1, C6.1, C7.1, C8.1, R1.1, R15.1, R16.1, U2.2 (3V3), U4.3 (VDD), U4.11 (VDDIO); also elsewhere on the board
+5V: J7.1; also elsewhere on the board
/MCU+IMU/IMU_CS_ACC: U2.17 (IO9), U4.14 (CSB1)
/MCU+IMU/IMU_CS_GYRO: U2.18 (IO10), U4.5 (CSB2)
/MCU+IMU/IMU_INT_ACC: U2.4 (IO4), U4.16 (INT1)
/MCU+IMU/IMU_INT_GYRO: U2.5 (IO5), U4.12 (INT3)
/MCU+IMU/IMU_MISO: U2.21 (IO13), U4.10 (SDO2), U4.15 (SDO1)
/MCU+IMU/IMU_MOSI: U2.20 (IO12), U4.9 (SDA/SDI)
/MCU+IMU/IMU_SCK: U2.19 (IO11), U4.8 (SCL/SCK)
/MCU+IMU/RXDO: J7.4, U2.36 (RXD0)
/MCU+IMU/TXDO: J7.3, U2.37 (TXD0)
CHARGE_STAT: U2.38 (IO2); also elsewhere on the board
GND: C4.2, C5.2, C6.2, C7.2, C8.2, D1.1 (K), J7.2, SW1.1, SW2.1, SW3.1, U2.1 (GND), U2.40 (GND), U2.41 (GND), U4.2 (NC), U4.4 (GNDA), U4.6 (GNDIO), U4.7 (PS); also elsewhere on the board
I2C_SCL: U2.7 (IO7); also elsewhere on the board
I2C_SDA: U2.12 (IO8); also elsewhere on the board
LIDAR_EN: U2.6 (IO6); also elsewhere on the board
LIDAR_RX: U2.11 (IO18); also elsewhere on the board
LIDAR_TX: U2.10 (IO17); also elsewhere on the board
unnamed: D1.2 (A), R2.2
unnamed: R1.2, SW1.2, U2.3 (EN)
unnamed: R15.2, SW2.2, U2.27 (IO0)
unnamed: R16.2, SW3.2, U2.22 (IO14)
unnamed: R2.1, U2.8 (IO15)
unnamed: R13.1, U2.13 (IO19)
unnamed: R14.1, U2.14 (IO20)
USB_D+: R14.2; also elsewhere on the board
USB_D-: R13.2; also elsewhere on the board
VBAT_SENSE: U2.39 (IO1); also elsewhere on the board

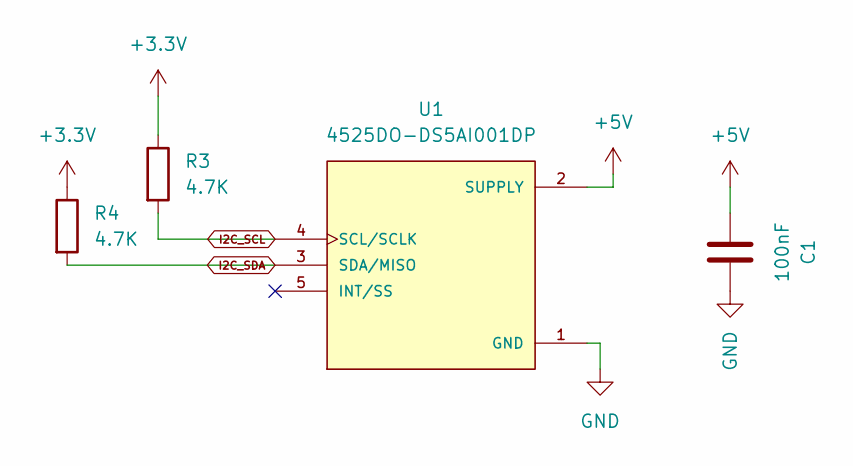
[picture p7: schematic airspeed.kicad_sch]

Parts:
C1: 100nF; C_0201_0603Metric_Pad0.64x0.40mm_HandSolder
R3, R4: 4.7K; R_0603_1608Metric_Pad0.98x0.95mm_HandSolder
U1: 4525DO-DS5AI001DP; TE_4525DO-DS5AI001DP; DigiKey_Part_Number 223-1110-ND

Connections:
+3.3V: R3.1, R4.1; also elsewhere on the board
+5V: C1.1, U1.2 (SUPPLY); also elsewhere on the board
GND: C1.2, U1.1 (GND); also elsewhere on the board
I2C_SCL: R3.2, U1.4 (SCL/SCLK); also elsewhere on the board
I2C_SDA: R4.2, U1.3 (SDA/MISO); also elsewhere on the board

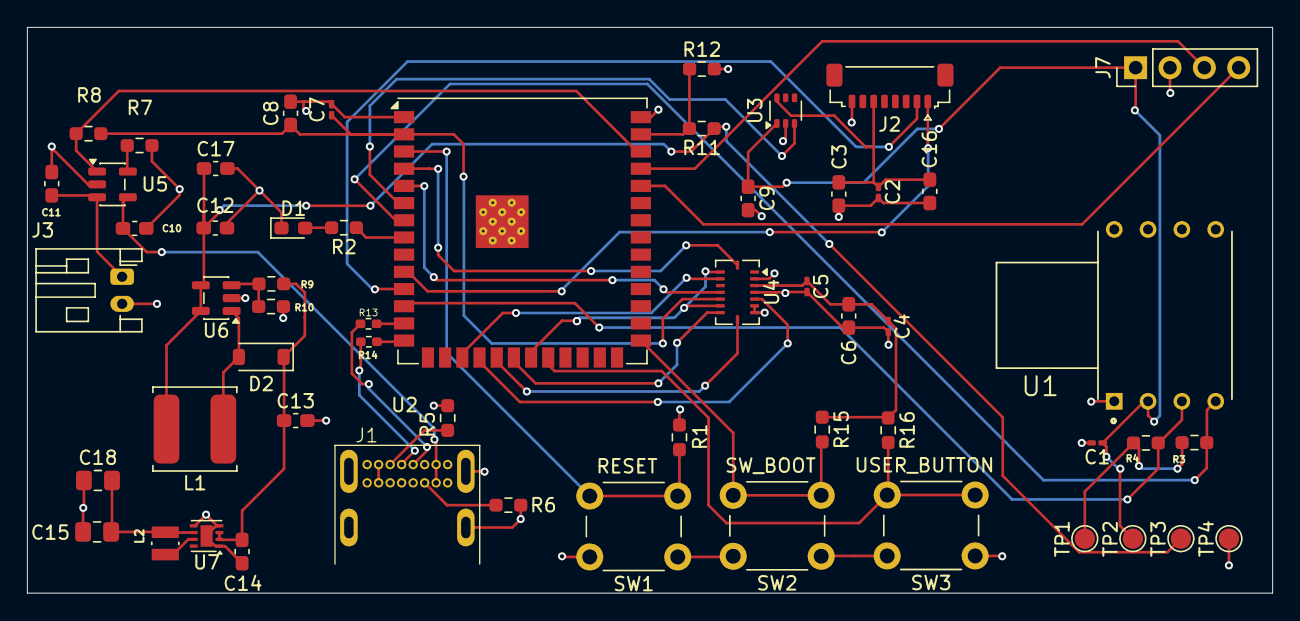
[picture p8: board ECE Capstone Schematic.kicad_pcb from above]

Board: 4 copper layers, 92.0 x 41.8 mm, 56 parts (0 on the bottom side), 37 nets.
