wayneblaylock/landing-assist/firmware/main/webserver.c

#include "esp_http_server.h"
#include "esp_log.h"
#include "esp_err.h"

static const char *TAG = "webserver";

extern const uint8_t index_html_start[] asm("_binary_index_html_start");
extern const uint8_t index_html_end[]   asm("_binary_index_html_end");

static esp_err_t root_get_handler(httpd_req_t *req)
{
    const size_t len = index_html_end - index_html_start;
    httpd_resp_set_type(req, "text/html");
    httpd_resp_send(req, (const char *)index_html_start, len);
    return ESP_OK;
}

static const httpd_uri_t root = {
    .uri       = "/",
    .method    = HTTP_GET,
    .handler   = root_get_handler,
    .user_ctx  = NULL
};

void webserver_start(void)
{
    httpd_handle_t server = NULL;
    httpd_config_t config = HTTPD_DEFAULT_CONFIG();
    config.server_port = 80;
    config.lru_purge_enable = true;

    ESP_LOGI(TAG, "Starting HTTP server on port %d", config.server_port);
    if (httpd_start(&server, &config) == ESP_OK) {
        httpd_register_uri_handler(server, &root);
        ESP_LOGI(TAG, "HTTP server started. Open http://192.168.4.1/");
    } else {
        ESP_LOGE(TAG, "Failed to start HTTP server");
    }
}
