wayneblaylock/landing-assist/(commit log)

2026-09-21 added BOM
    [ECE Captstone BOM.xlsx]
2026-09-21 upated BOM
    [ECE Captstone BOM.xlsx]
2026-09-21 edited BOM
2026-10-08 updated BOM
    [ECE Captstone BOM.xlsx]
2026-10-10 Updated firmware: main loop and ap software demo. Tuned radio TX power for optimal power saving.
2026-10-16 Create KiCad folder for ECE Capstone
2026-10-16 Add ECE Capstone KiCad schematic and PCB
2026-10-16 Fix Airspeed and LiDAR schematic references
2026-10-16 Add static ADI page for ESP32 hosting
2026-10-19 Added tubing part to BOM
2026-10-19 Added case/ and relevant files
2026-10-22 Update PCB power schematic and custom footprints
2026-10-22 Save remaining power schematic changes
2026-10-22 Update KiCad schematics and PCB footprints
2026-10-26 added madgwick filter
2026-10-28 partially-built bmi088 driver. Accelerometer data working
2026-10-31 Modified bmi088 driver to add gyroscope functionality. Both working!
2026-11-03 Update KiCad PCB schematics and USB-C connector footprint
2026-11-07 Attitude (pitch/roll) component working
2026-11-10 Add LW20/C LiDAR bring-up component and minimal main for slant-range test
2026-11-10 Add MS4525DO airspeed sensor bring-up component and dual sensor main
2026-11-10 Airspeed: add I2C bus scan and measurement-request sequence
2026-11-10 Airspeed: switch to legacy I2C driver with longer timeout and quiet probe
2026-11-10 Airspeed: add driver to PRIV_REQUIRES for legacy I2C
2026-11-10 Airspeed: correct SDA/SCL pins to match working wiring
2026-11-11 Airspeed: restore SDA=GPIO8 SCL=GPIO9 (sensor pins 3/4)
